A-S31/smart-greenhouse-project-GroupC3/IndividualReports/Indiviual report Leen Hallal 6538.pdf

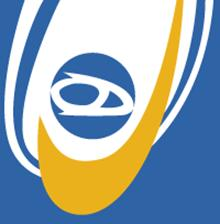
[picture p1: figure]

### Lebanese University

### Faculty of Engineering-Branch III

### Department of Mechanical Engineering

# Sensors and Instrumentation

# Smart Greenhouse Monitor and Controller

# Academic year: 2025-2026

# Presented to: Dr. M. Aoudi

# Prepared by:

# Leen Hallal 6538

### الجامعة اللبنانية

### كلية الهندسة – الفرع الثالث

### قسم هندسة الميكانيك

# 1. Contribution Summary

I contributed to the Smart Greenhouse Automation project by drafting the problem statement, designing the hardware circuit connections, and building a transitional path between hardware and software. I listed sensor connections for hardware teammates and explained sampling rates for software teammates based on physical dynamics (soil moisture every 3 s, DHT11 every 2 s, HX711 every 2 s, YF-S201 every 1 s, LDR every 200 ms, LCD every 3 s). I recorded raw sensor results, applied the logic of existing functions manually to convert values, derived calibration equations, and calculated errors before and after calibration. I prepared tables for absolute and relative errors, analyzed graphs, and collaborated integrated findings into the final report.

# 2. Evidence of Work Performed

- Drafted problem statement and system scope.

# - Looked upon sensors types and helped in making the selection

# - “Uploaded circuit schematic and explained hardware connections”

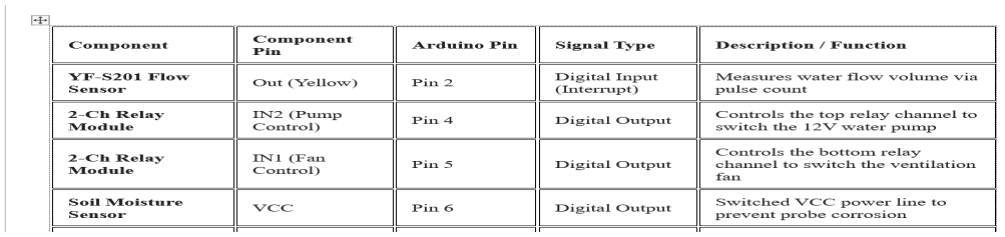
[picture p2: figure]

# - Defined sensor sampling rates based on physical dynamics

- Recorded raw sensor data (soil moisture, LDR, HX711, DHT11, YF-S201).

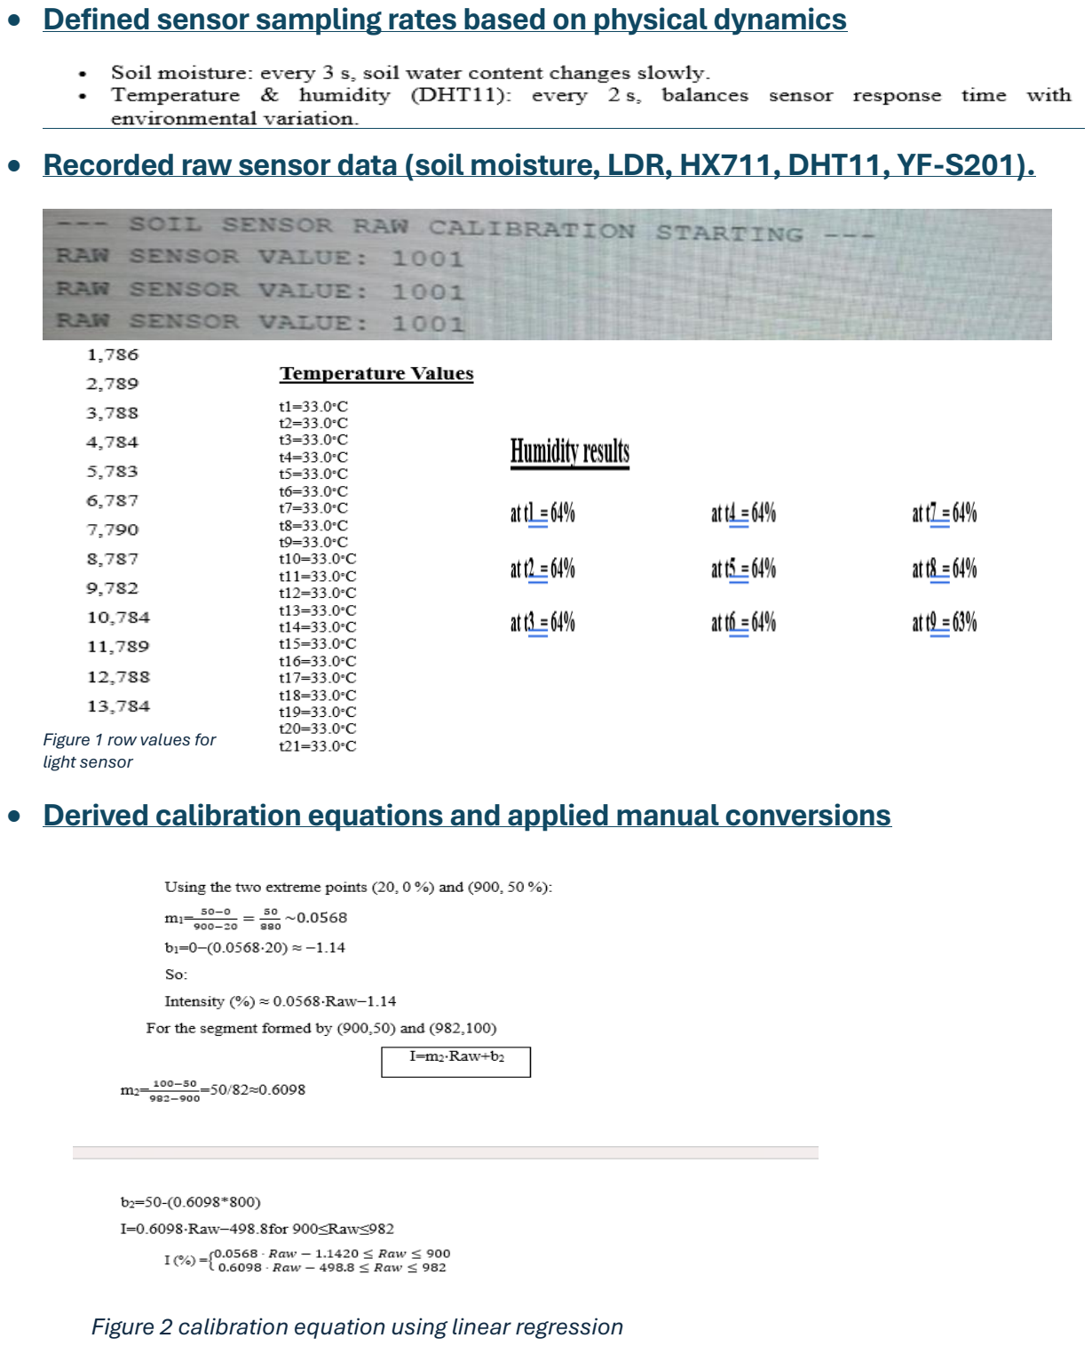
[picture p3: page 3]

# - Derived calibration equations and applied manual conversions

Figure 1 row values for
light sensor

## Figure 2 calibration equation using linear regression

## Figure 3 manual calculation of the calibrated values

# - Calculated absolute and relative errors before and after calibration for each

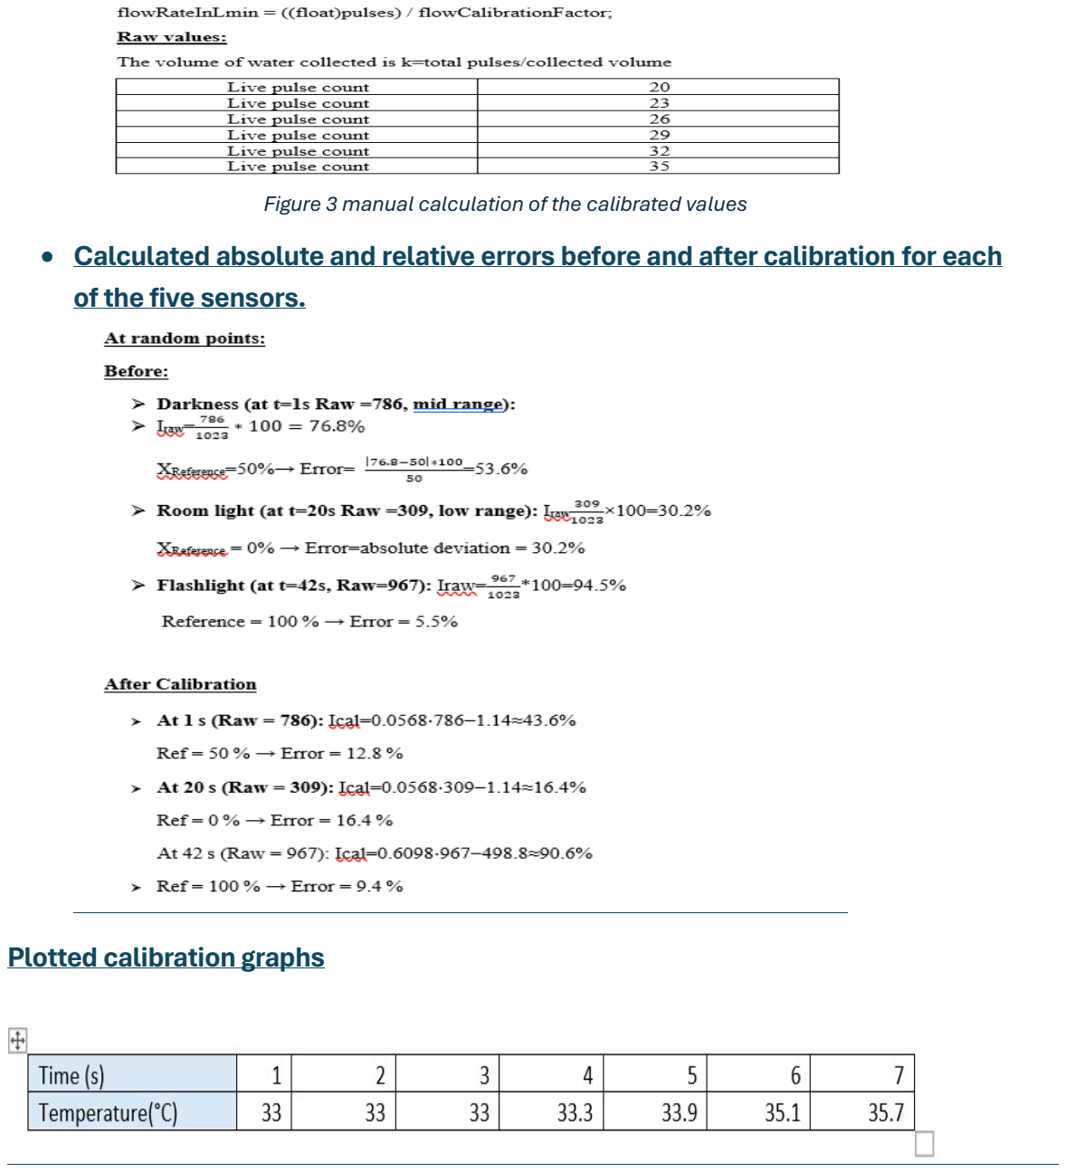
[picture p4: page 4]

of the five sensors.

# Plotted calibration graphs

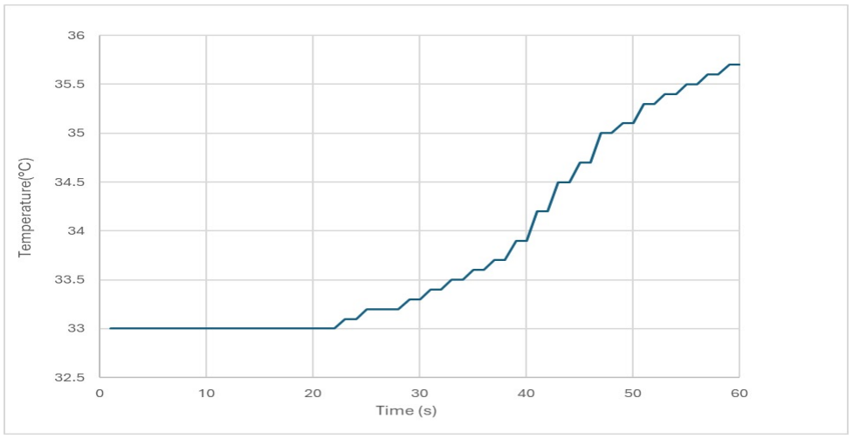
[picture p5: figure]

# - Collaborated with teammates to finalize calibration section

## We cross‑checked error values at reference points to confirm accuracy before

finalizing the calibration section.

# GitHub Commit History

⎯ Commit 1 Added ProblemStatement.md describing greenhouse automation challenge
⎯ Commit 2 Documented system architecture and hardware connections in SystemArchitecture.md ⎯ Commit 3 Defined sensor sampling rates based on physical dynamics in SamplingRates.md
⎯ Commit 4 Uploaded raw sensor data table for soil moisture, LDR, HX711, and DHT11
⎯ Commit 5 Derived calibration equations for soil moisture, LDR, DHT11, flow, and weight sensors ⎯ Commit 6 Calculated absolute and relative errors before and after calibration
⎯ Commit 7 Summarized calibration procedures, error analysis, and team collaboration
Personal reflection describing lessons learned.

Working on this project taught me valuable lessons both technically and personally. On the technical side, I gained deeper experience in sensor calibration, error analysis, and modular firmware design, which showed me how important accuracy and structure are in embedded systems. I learned how to organize data, apply calibration equations, and document results clearly so that the system can be replicated and improved by others. On the personal side, I realized the importance of teamwork and communication—sharing tasks with my peers, trusting their contributions, and aligning our work through Git commits made the process smoother and more professional. I also discovered how meaningful it is to write clear commit messages and maintain a clean repository history, since these small details reflect discipline and responsibility. Overall, this project strengthened my technical confidence while also teaching me patience, collaboration, and the value of presenting work in a professional way.
