A-S31/smart-greenhouse-project-GroupC3/ProblemStatement.md

# Problem Statement

Human observation and manual control are the traditional management techniques used in greenhouses. These methods often result in inconsistent watering, lighting, and ventilation.

The problem to be addressed is how to maintain optimal and healthy growth conditions automatically using real-time sensor feedback. The goal is to design a reliable and low-cost embedded system that monitors environmental variables and takes corrective actions when thresholds are exceeded.
