A-S31/smart-greenhouse-project-GroupC3/ErrorTables.xlsx

Sheet: Soil moisture
Condition | Raw Value | Reference (%) | Measured (%) | Absolute Error | Relative Error (%)
Dry | 1001 | 0 | 97.9 | -97.9 | #DIV/0!
Semi-wet | 338 | 50 | 33 | 17 | 34
Wet | 289 | 100 | 28.3 | 71.7 | 71.7

Sheet: LDR
Condition | Raw Value | Reference (%) | Measured (%) | Absolute Error | Relative Error (%)
Darkness | 20 | 0 | 2 | -2 | #DIV/0!
Room Light | 900 | 50 | 88 | -38 | 76
Flashlight | 982 | 100 | 96 | 4 | 4

Sheet: Temperature
Instant | Measured (°C) | Reference (°C) | Absolute Error | Relative Error (%)
t1 | 33 | 34.35 | -1.35 | 3.930131004
t30 | 33.3 | 34.35 | -1.05 | 3.056768559
t41 | 34.2 | 34.35 | -0.15 | 0.4366812227
t60 | 35.7 | 34.35 | 1.35 | 3.930131004

Sheet: Humidity
Instant | Measured (%RH) | Reference (%RH) | Absolute Error | Relative Error (%)
t1 | 64 | 65 | -1 | 1.538461538
t30 | 64 | 65 | -1 | 1.538461538
t60 | 64 | 65 | -1 | 1.538461538

Sheet: flow
Condition | Pulse Count | Reference (L/min) | Measured (L/min) | Absolute Error | Relative Error (%)
Pump ON | 75 | 10 | 9.8 | 0.2 | 2
Pump OFF | 0 | 0 | 0 | 0 | 0

Sheet: Sheet8
Condition | Raw Value | Reference (kg) | Measured (kg) | Absolute Error | Relative Error (%)
Dry Pot | 1020 | 0.5 | 0.48 | 0.02 | 4
Wet Pot | 2048 | 1 | 0.98 | 0.02 | 2
