A-S31/smart-greenhouse-project-GroupC3/CalibrationSection.md

Summarized calibration procedures, error analysis, and team collaboration
