A-S31/smart-greenhouse-project-GroupC3/(commit log)

2026-07-15 Uploaded raw sensor data table for soil moisture, LDR, HX711, and DHT11
    [RawData.xlsx]
2026-07-15 Derived calibration equations for soil moisture, LDR, DHT11, flow, and weight sensors
2026-07-15 Calculated absolute and relative errors before and after calibration
    [ErrorTables.xlsx]
2026-07-15 Summarized calibration procedures, error analysis, and team collaboration
